PacktPublishing/Architecting-High-Performance-Embedded-Systems/README.md

# Architecting High-Performance Embedded Systems

<a href="https://www.packtpub.com/product/architecting-high-performance-embedded-systems/9781789955965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">Architecting High-Performance Embedded Systems</a>

This is the code repository for [Architecting High-Performance Embedded Systems](https://www.packtpub.com/product/architecting-high-performance-embedded-systems/9781789955965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), published by Packt.

**Design and build high-performance real-time digital systems based on FPGAs and custom circuits**

## What is this book about?
Modern digital devices used in homes, cars, and wearables contain highly sophisticated computing capabilities composed of embedded systems that generate, receive, and process digital data streams at rates up to multiple gigabits per second. This book will show you how to use Field Programmable Gate Arrays (FPGAs) and high-speed digital circuit design to create your own cutting-edge digital systems. 

This book covers the following exciting features:
* Understand the fundamentals of real-time embedded systems and sensors
* Discover the capabilities of FPGAs and how to use FPGA development tools
* Learn the principles of digital circuit design and PCB layout with KiCad
* Construct high-speed circuit board prototypes at low cost
* Design and develop high-performance algorithms for FPGAs
Develop robust, reliable, and efficient firmware in C
Thoroughly test and debug embedded device hardware and firmware

If you feel this book is for you, get your [copy](https://www.amazon.com/dp/1789955963) today!

## Instructions and Navigation
All of the code is organized into folders based on chapter number.

**What you need to work with the examples in this book:**
This book is for software developers, IoT engineers, and anyone who wants to understand the process of developing high-performance embedded systems. You’ll also find this book useful if you want to learn about the fundamentals of FPGA development and all aspects of firmware development in C and C++. Familiarity with the C language, digital circuits, and electronic soldering is necessary to get started.

With the following software and hardware you can run all code files present in the book.
### Software and Hardware List
| Software or hardware | OS required |
| --- | --- |
| [Xilinx Vivado](https://www.xilinx.com/support/download.html) | Windows, Mac OS X, and Linux (Any) |
| [KiCad](https://kicad.org/download/) | Windows, Mac OS X, and Linux (Any) |
| [Arty A7-100](https://www.xilinx.com/products/boards-and-kits/1-w51quh.html) | Windows, Mac OS X, and Linux (Any) |

We also provide a PDF file that has color images of the screenshots/diagrams used in this book. [Click here to download it](https://static.packt-cdn.com/downloads/9781789955965_ColorImages.pdf).

## Get to Know the Author
**Jim Ledin**
Jim Ledin is the CEO of Ledin Engineering, Inc. Jim is an expert in embedded software and hardware design, development, and testing. He is also accomplished in embedded system cybersecurity assessment and penetration testing. He has a B.S. degree in aerospace engineering from Iowa State University and an M.S. degree in electrical and computer engineering from Georgia Institute of Technology. Jim is a registered professional electrical engineer in California, a Certified Information System Security Professional (CISSP), a Certified Ethical Hacker (CEH), and a Certified Penetration Tester (CPT).

## Other books by the author
* Modern Computer Architecture and Organization [[Packt]](https://www.packtpub.com/in/cloud-networking/modern-computer-architecture-and-organization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) [[Amazon]](https://www.amazon.com/dp/1838984399)
### Download a free PDF

 <i>If you have already purchased a print or Kindle version of this book, you can get a DRM-free PDF version at no cost.<br>Simply click on the link to claim your free PDF.</i>
<p align="center"> <a href="https://packt.link/free-ebook/9781789955965">https://packt.link/free-ebook/9781789955965 </a> </p>
