PacktPublishing/Architecting-High-Performance-Embedded-Systems/Chapter02/README.md

__Architecting-High-Performance-Embedded-Systems__, by Jim Ledin. Published by Packt Publishing.
# Chapter 2 - Sensing the world

This chapter introduces the principles and implementations of sensors used in a wide variety of embedded applications. Passive sensors measure attributes of the world such as temperature, pressure, humidity, light intensity, and atmospheric composition. Active sensors use energy-emitting technologies like radar and lidar to detect objects and measure their position and velocity.

This chapter introduces a broad range of sensor types as well as the communication protocols used for transferring sensor data into a processor. The chapter also discusses the processing an embedded system must perform on raw sensor measurements to provide actionable data for use by a processing algorithm. 

After completing this chapter, you will have learned about many of the different types of sensors used in embedded systems and will understand what passive and active sensors are and will be familiar with several types of passive and active sensors. You will also understand some of the data processing methods commonly used on the raw measurements provided by sensors.

We will cover the following topics in this chapter: 
* Introducing passive, active and smart sensors
* Applying analog-to-digital converters and sensor circuits
* The types of sensors used in embedded systems
* Communicating with sensors
* Processing sensor data

# Chapter Files

[ArduinoHysteresis.c.ino](src/ArduinoHysteresis.c.ino) is the Arduino implementation of the phototransistor sensor processing algorithm presented in the *Communicating with sensors* section of chapter 2.
