PacktPublishing/Architecting-High-Performance-Embedded-Systems/Chapter04/README.md

__Architecting-High-Performance-Embedded-Systems__, by Jim Ledin. Published by Packt Publishing.
# Chapter 4 - Developing your first FPGA program

This chapter begins with a discussion on the effective use of FPGA devices in real-time embedded systems and continues with a description of the functional elements contained within standard FPGAs. The range of FPGA design languages, including hardware description languages (HDLs), block diagram methods, and popular software programming languages including C and C++, is introduced. The chapter continues with an overview of the FPGA development process and concludes with a complete example of an FPGA development cycle starting with a statement of system requirements and ending with a functional system implemented in a low-cost FPGA development board.

After completing this chapter, you will know how FPGAs can be applied in real-time embedded system architectures and will understand the components that make up an FPGA integrated circuit. You will have learned about the programming languages used in the design of FPGA algorithms and will understand the sequence of steps to develop an FPGA-based application. You will also have worked through a complete FPGA development example on a low-cost development board using free FPGA software tools.

We will cover the following topics in this chapter: 
* Using FPGAs in real-time embedded system designs
* FPGA implementation languages
* The FPGA development process
* Developing your first FPGA project

# Chapter Files

[ArtyAdder project](src/ArtyAdder) contains the final version of the Vivado project example we worked through in Chapter 4.
