PacktPublishing/Architecting-High-Performance-Embedded-Systems/Chapter06/src/oscilloscope-circuit/Oscilloscope.kicad_pcb

## KiCad design Chapter06/src/oscilloscope-circuit/Oscilloscope.kicad_pcb (2021-01-16)

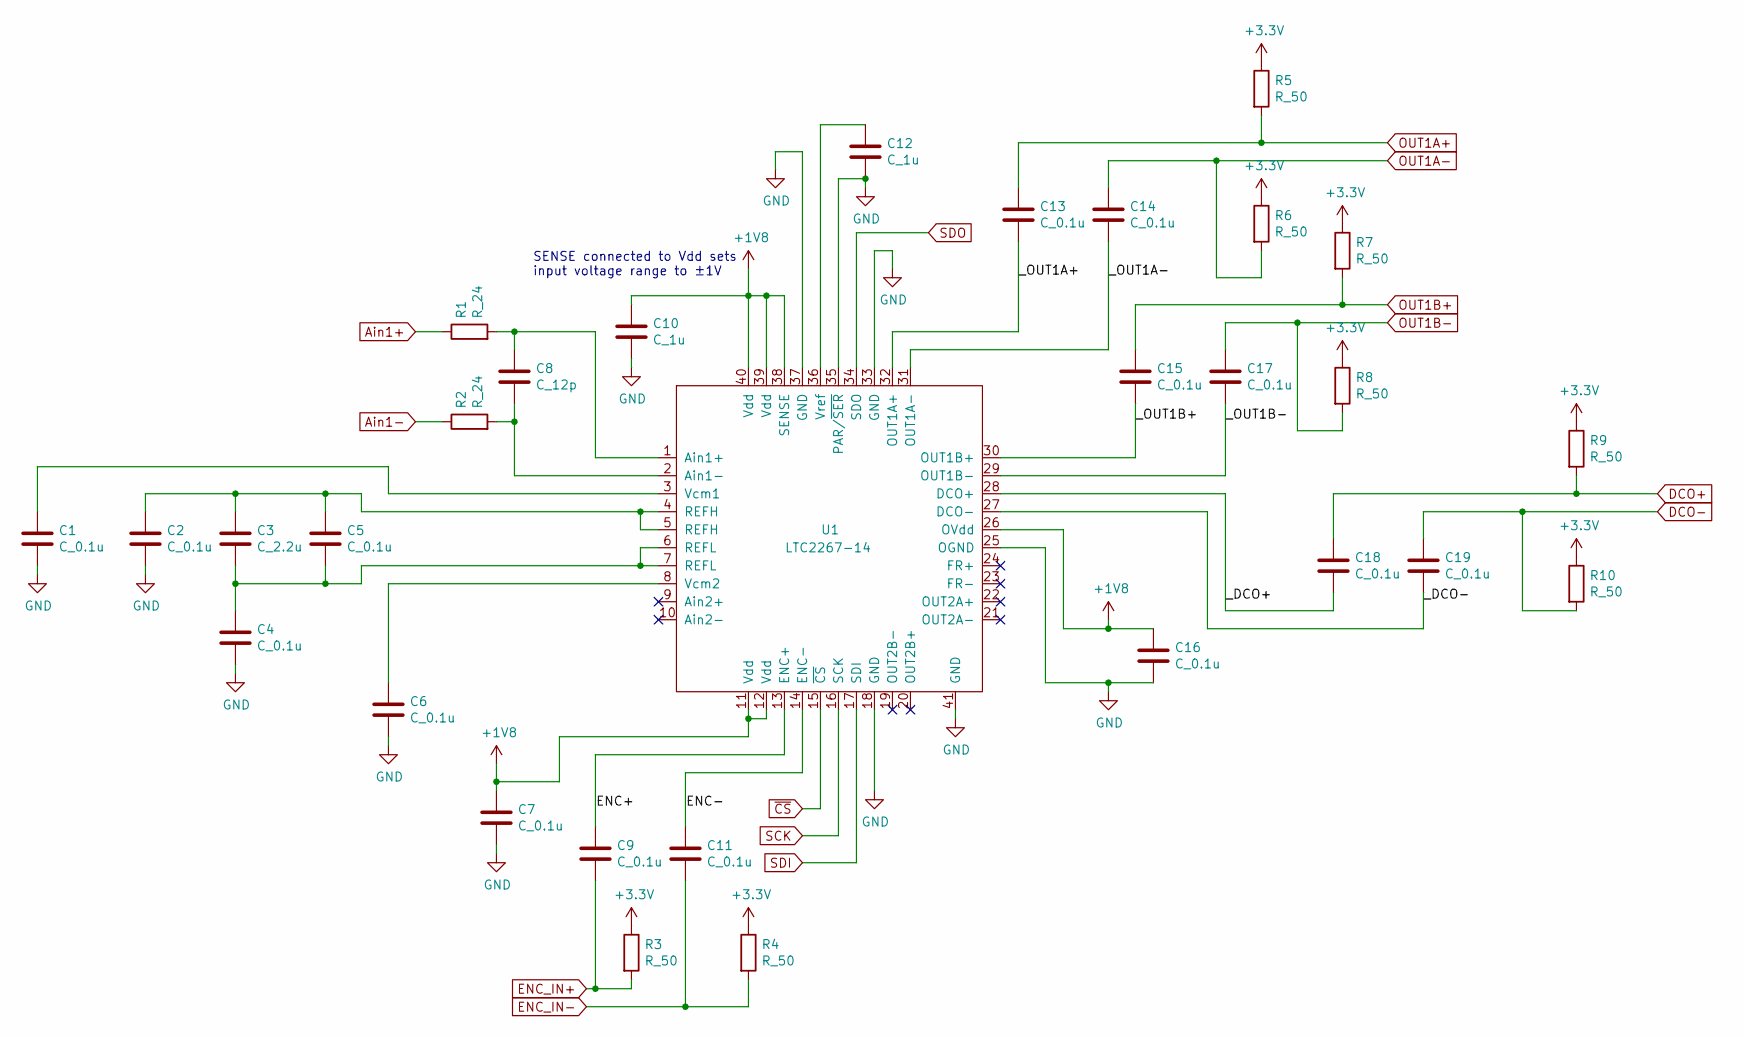
[picture p1: schematic ADC.sch]

Parts:
C1, C2, C4, C5, C6, C7, C9, C11, C13, C14, C15, C16, C17, C18, C19: C_0.1u; C_0402_1005Metric
C3: C_2.2u; C_0603_1608Metric
C8: C_12p; C_0402_1005Metric
C10, C12: C_1u; C_0603_1608Metric
R1, R2: R_24; R_0402_1005Metric
R3, R4, R5, R6, R7, R8, R9, R10: R_50; R_0402_1005Metric
U1: LTC2267-14; QFN-40-1EP_6x6mm_P0.5mm_EP4.6x4.6mm_ThermalVias

Connections:
+1V8: C7.1, C10.1, C16.1, U1.11 (Vdd), U1.12 (Vdd), U1.26 (OVdd), U1.38 (SENSE), U1.39 (Vdd), U1.40 (Vdd); also elsewhere on the board
+3V3: R3.1, R4.1, R5.1, R6.1, R7.1, R8.1, R9.1, R10.1; also elsewhere on the board
/ADC/ENC+: C9.1, U1.13 (ENC+)
/ADC/ENC-: C11.1, U1.14 (ENC-)
/ADC/_DCO+: C18.2, U1.28 (DCO+)
/ADC/_DCO-: C19.2, U1.27 (DCO-)
/ADC/_OUT1A+: C13.2, U1.32 (OUT1A+)
/ADC/_OUT1A-: C14.2, U1.31 (OUT1A-)
/ADC/_OUT1B+: C15.2, U1.30 (OUT1B+)
/ADC/_OUT1B-: C17.2, U1.29 (OUT1B-)
Ain1+: R1.1; also elsewhere on the board
Ain1-: R2.1; also elsewhere on the board
DCO+: C18.1, R9.2; also elsewhere on the board
DCO-: C19.1, R10.2; also elsewhere on the board
ENC_IN+: C9.2, R3.2; also elsewhere on the board
ENC_IN-: C11.2, R4.2; also elsewhere on the board
GND: C1.2, C2.2, C4.2, C6.2, C7.2, C10.2, C12.2, C16.2, U1.18 (GND), U1.25 (OGND), U1.33 (GND), U1.35 (PAR/~SER), U1.37 (GND), U1.41 (GND); also elsewhere on the board
unnamed: C1.1, U1.3 (Vcm1)
unnamed: C2.1, C3.1, C5.1, U1.4 (REFH), U1.5 (REFH)
unnamed: C3.2, C4.1, C5.2, U1.6 (REFL), U1.7 (REFL)
unnamed: C6.1, U1.8 (Vcm2)
unnamed: C8.1, R1.2, U1.1 (Ain1+)
unnamed: C8.2, R2.2, U1.2 (Ain1-)
unnamed: C12.1, U1.36 (Vref)
OUT1A+: C13.1, R5.2; also elsewhere on the board
OUT1A-: C14.1, R6.2; also elsewhere on the board
OUT1B+: C15.1, R7.2; also elsewhere on the board
OUT1B-: C17.1, R8.2; also elsewhere on the board
SCK: U1.16 (SCK); also elsewhere on the board
SDI: U1.17 (SDI); also elsewhere on the board
SDO: U1.34 (SDO); also elsewhere on the board
~CS: U1.15 (~CS); also elsewhere on the board

Notes on the sheet:
SENSE connected to Vdd sets input voltage range to ±1V

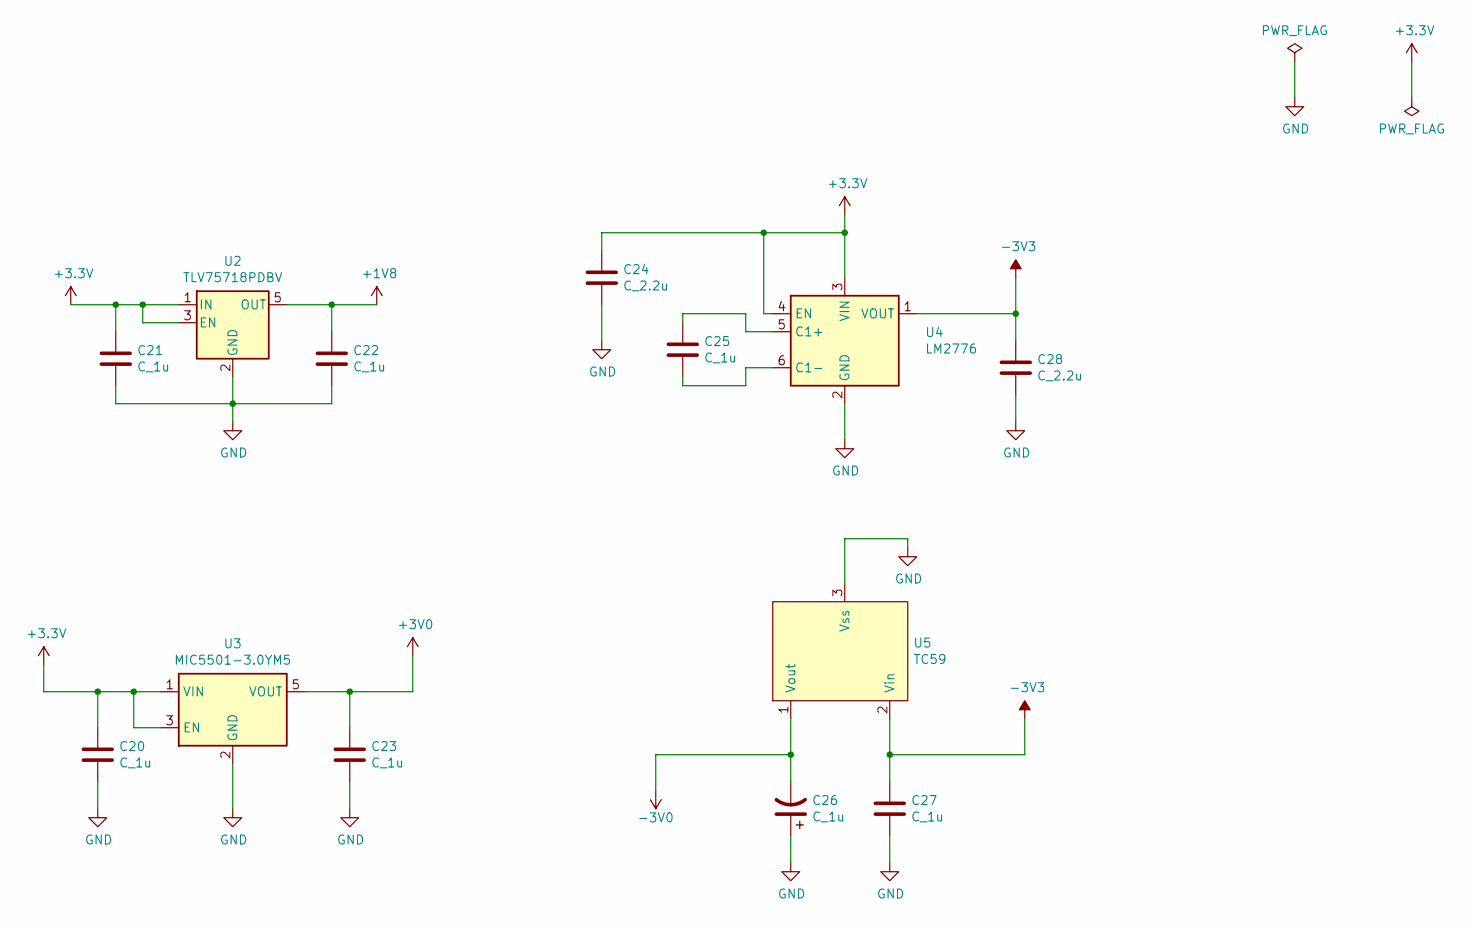
[picture p2: schematic Power Supply.sch]

Parts:
C20, C21, C22, C23, C25, C27: C_1u; C_0603_1608Metric
C24, C28: C_2.2u; C_0603_1608Metric
C26: C_1u; CP_EIA-2012-12_Kemet-R
U2: TLV75718PDBV; SOT-23-5
U3: MIC5501-3.0YM5; SOT-23-5
U4: LM2776; SOT-23-6
U5: TC59; SOT-23

Connections:
+1V8: C22.1, U2.5 (OUT); also elsewhere on the board
+3V0: C23.1, U3.5 (VOUT); also elsewhere on the board
+3V3: C20.1, C21.1, C24.1, U2.1 (IN), U2.3 (EN), U3.1 (VIN), U3.3 (EN), U4.3 (VIN), U4.4 (EN); also elsewhere on the board
-3V0: C26.2, U5.1 (Vout); also elsewhere on the board
-3V3: C27.1, C28.1, U4.1 (VOUT), U5.2 (Vin)
GND: C20.2, C21.2, C22.2, C23.2, C24.2, C26.1, C27.2, C28.2, U2.2 (GND), U3.2 (GND), U4.2 (GND), U5.3 (Vss); also elsewhere on the board
unnamed: C25.1, U4.5 (C1+)
unnamed: C25.2, U4.6 (C1-)

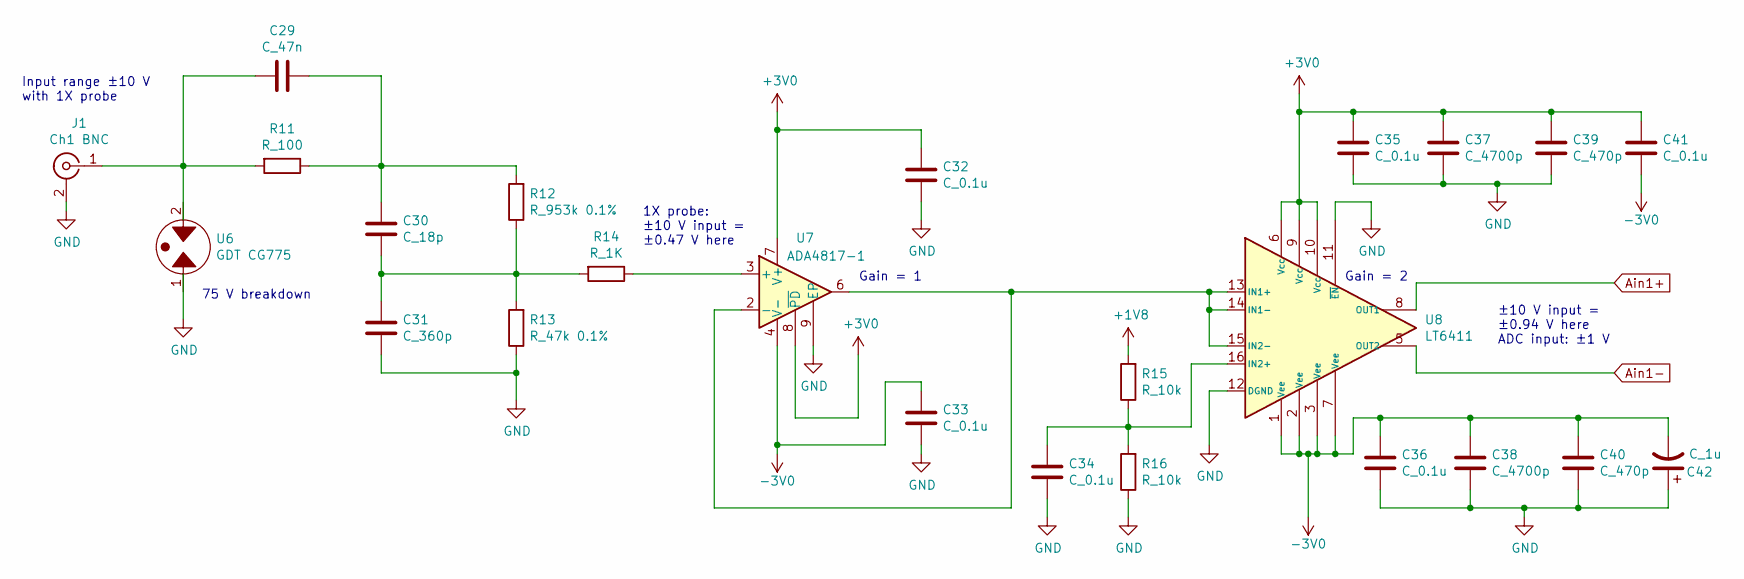
[picture p3: schematic Analog Inputs.sch]

Parts:
C29: C_47n; C_0402_1005Metric
C30: C_18p; C_0402_1005Metric
C31: C_360p; C_0402_1005Metric
C32, C33, C34, C35, C36, C41: C_0.1u; C_0402_1005Metric
C37, C38: C_4700p; C_0402_1005Metric
C39, C40: C_470p; C_0402_1005Metric
C42: C_1u; CP_EIA-2012-12_Kemet-R
J1: Ch1 BNC; BNC_Amphenol_B6252HB-NPP3G-50_Horizontal
R11: R_100; R_0402_1005Metric
R12: R_953k 0.1%; R_0402_1005Metric
R13: R_47k 0.1%; R_0402_1005Metric
R14: R_1K; R_0402_1005Metric
R15, R16: R_10k; R_0402_1005Metric
U6: GDT CG775; Littelfuse-GTCC23-XXXM-R01-2-Series-GDT
U7: ADA4817-1; SOIC-8-1EP_3.9x4.9mm_P1.27mm_EP2.29x3mm
U8: LT6411; QFN-16-1EP_3x3mm_P0.5mm_EP1.7x1.7mm

Connections:
+1V8: R15.2; also elsewhere on the board
+3V0: C32.2, C35.2, C37.2, C39.2, C41.2, U7.7 (V+), U7.8 (~PD), U8.6 (Vcc), U8.9 (Vcc), U8.10 (Vcc); also elsewhere on the board
-3V0: C33.2, C36.2, C38.2, C40.2, C41.1, C42.2, U7.4 (V-), U8.1 (Vee), U8.2 (Vee), U8.3 (Vee), U8.7 (Vee); also elsewhere on the board
Ain1+: U8.8 (OUT1); also elsewhere on the board
Ain1-: U8.5 (OUT2); also elsewhere on the board
GND: C31.1, C32.1, C33.1, C34.1, C35.1, C36.1, C37.1, C38.1, C39.1, C40.1, C42.1, J1.2 (Ext), R13.1, R16.1, U6.1, U7.9 (EP), U8.11 (~EN), U8.12 (DGND); also elsewhere on the board
unnamed: C29.1, C30.2, R11.1, R12.2
unnamed: C29.2, J1.1 (In), R11.2, U6.2
unnamed: C30.1, C31.2, R12.1, R13.2, R14.2
unnamed: C34.2, R15.1, R16.2, U8.16 (IN2+)
unnamed: R14.1, U7.3 (+)
unnamed: U7.2 (-), U7.6, U8.13 (IN1+), U8.14 (IN1-), U8.15 (IN2-)

Notes on the sheet:
Input range ±10 V with 1X probe
Gain = 2
1X probe: ±10 V input = ±0.47 V here
±10 V input = ±0.94 V here ADC input: ±1 V
Gain = 1
75 V breakdown

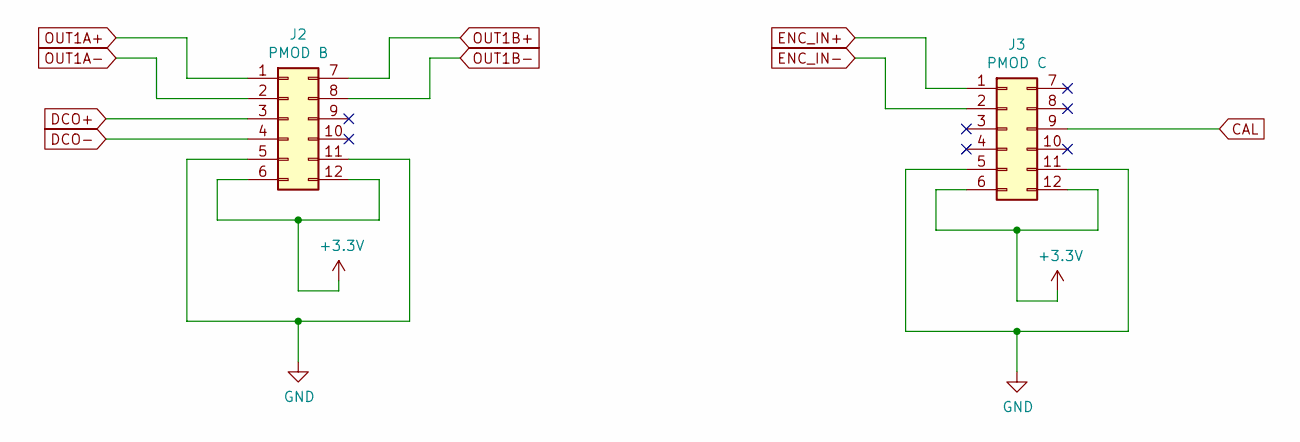
[picture p4: schematic PMOD Ports.sch]

Parts:
J2: PMOD B; PinHeader_2x06_P2.54mm_renumbered
J3: PMOD C; PinHeader_2x06_P2.54mm_renumbered

Connections:
+3V3: J2.6, J2.12, J3.6, J3.12; also elsewhere on the board
CAL: J3.9; also elsewhere on the board
DCO+: J2.3; also elsewhere on the board
DCO-: J2.4; also elsewhere on the board
ENC_IN+: J3.1; also elsewhere on the board
ENC_IN-: J3.2; also elsewhere on the board
GND: J2.5, J2.11, J3.5, J3.11; also elsewhere on the board
OUT1A+: J2.1; also elsewhere on the board
OUT1A-: J2.2; also elsewhere on the board
OUT1B+: J2.7; also elsewhere on the board
OUT1B-: J2.8; also elsewhere on the board

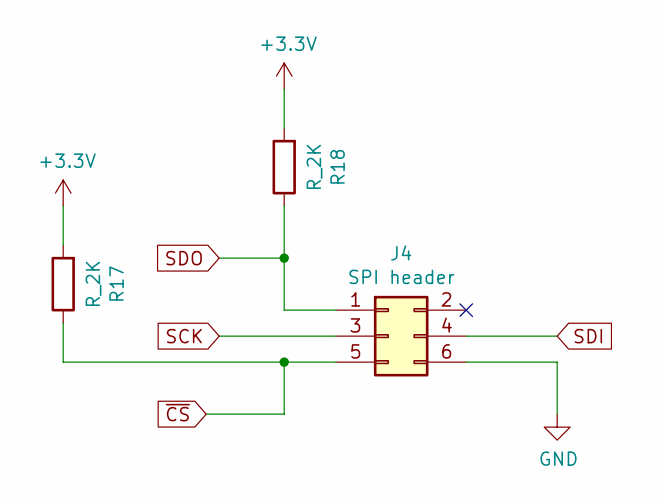
[picture p5: schematic SPI.sch]

Parts:
J4: SPI header; PinHeader_2x03_P2.54mm_Vertical
R17, R18: R_2K; R_0402_1005Metric

Connections:
+3V3: R17.2, R18.2; also elsewhere on the board
GND: J4.6; also elsewhere on the board
SCK: J4.3; also elsewhere on the board
SDI: J4.4; also elsewhere on the board
SDO: J4.1, R18.1; also elsewhere on the board
~CS: J4.5, R17.1; also elsewhere on the board

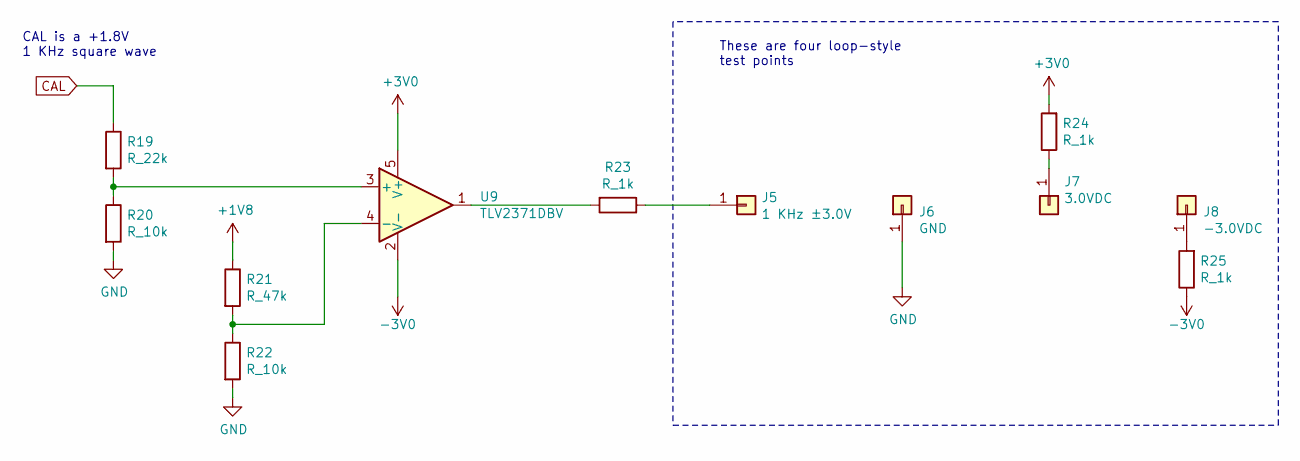
[picture p6: schematic Calibration.sch]

Parts:
J5: 1 KHz ±3.0V; TestPoint_Loop_D2.60mm_Drill1.6mm_Beaded
J6: GND; TestPoint_Loop_D2.60mm_Drill1.6mm_Beaded
J7: 3.0VDC; TestPoint_Loop_D2.60mm_Drill1.6mm_Beaded
J8: -3.0VDC; TestPoint_Loop_D2.60mm_Drill1.6mm_Beaded
R19: R_22k; R_0402_1005Metric
R20, R22: R_10k; R_0402_1005Metric
R21: R_47k; R_0402_1005Metric
R23, R24, R25: R_1k; R_0402_1005Metric
U9: TLV2371DBV; SOT-23-5

Connections:
+1V8: R21.1; also elsewhere on the board
+3V0: R24.2, U9.5 (V+); also elsewhere on the board
-3V0: R25.1, U9.2 (V-); also elsewhere on the board
CAL: R19.1; also elsewhere on the board
GND: J6.1, R20.2, R22.2; also elsewhere on the board
unnamed: J5.1, R23.1
unnamed: J7.1, R24.1
unnamed: J8.1, R25.2
unnamed: R19.2, R20.1, U9.3 (+)
unnamed: R21.2, R22.1, U9.4 (-)
unnamed: R23.2, U9.1

Notes on the sheet:
CAL is a +1.8V 1 KHz square wave
These are four loop-style test points

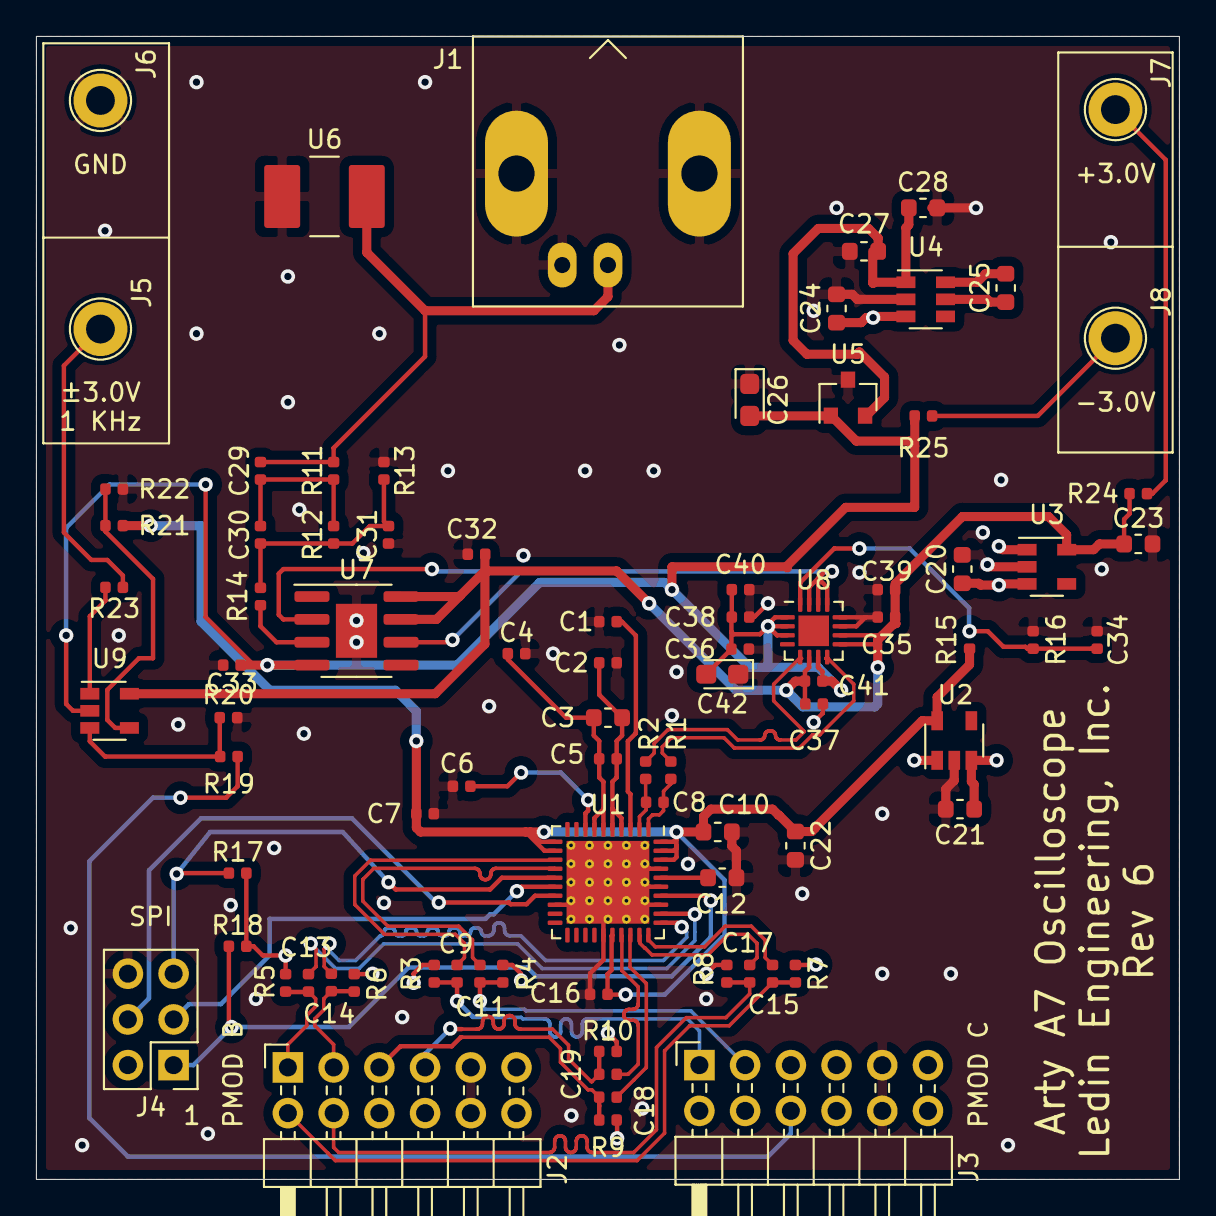
[picture p7: board Oscilloscope.kicad_pcb from above]

Board: 4 copper layers, 63.5 x 63.5 mm, 84 parts (0 on the bottom side), 50 nets.
