PacktPublishing/Architecting-High-Performance-Embedded-Systems/Chapter04/src/ArtyAdder/ArtyAdder.runs/synth_1/.Xil/ARTY_ADDER_propImpl.xdc

set_property SRC_FILE_INFO {cfile:C:/Projects/Architecting-High-Performance-Embedded-Systems/Chapter04/src/ArtyAdder/ArtyAdder.srcs/constrs_1/new/Arty-A7-100.xdc rfile:../../../ArtyAdder.srcs/constrs_1/new/Arty-A7-100.xdc id:1} [current_design]
set_property src_info {type:XDC file:1 line:11 export:INPUT save:INPUT read:READ} [current_design]
set_property -dict { PACKAGE_PIN A8    IOSTANDARD LVCMOS33 } [get_ports { sw[0] }]; #IO_L12N_T1_MRCC_16 Sch=sw[0]
set_property src_info {type:XDC file:1 line:12 export:INPUT save:INPUT read:READ} [current_design]
set_property -dict { PACKAGE_PIN C11   IOSTANDARD LVCMOS33 } [get_ports { sw[1] }]; #IO_L13P_T2_MRCC_16 Sch=sw[1]
set_property src_info {type:XDC file:1 line:13 export:INPUT save:INPUT read:READ} [current_design]
set_property -dict { PACKAGE_PIN C10   IOSTANDARD LVCMOS33 } [get_ports { sw[2] }]; #IO_L13N_T2_MRCC_16 Sch=sw[2]
set_property src_info {type:XDC file:1 line:14 export:INPUT save:INPUT read:READ} [current_design]
set_property -dict { PACKAGE_PIN A10   IOSTANDARD LVCMOS33 } [get_ports { sw[3] }]; #IO_L14P_T2_SRCC_16 Sch=sw[3]
set_property src_info {type:XDC file:1 line:18 export:INPUT save:INPUT read:READ} [current_design]
set_property -dict { PACKAGE_PIN F6    IOSTANDARD LVCMOS33 } [get_ports { led0_g }]; #IO_L19N_T3_VREF_35 Sch=led0_g
set_property src_info {type:XDC file:1 line:31 export:INPUT save:INPUT read:READ} [current_design]
set_property -dict { PACKAGE_PIN H5    IOSTANDARD LVCMOS33 } [get_ports { led[0] }]; #IO_L24N_T3_35 Sch=led[4]
set_property src_info {type:XDC file:1 line:32 export:INPUT save:INPUT read:READ} [current_design]
set_property -dict { PACKAGE_PIN J5    IOSTANDARD LVCMOS33 } [get_ports { led[1] }]; #IO_25_35 Sch=led[5]
set_property src_info {type:XDC file:1 line:33 export:INPUT save:INPUT read:READ} [current_design]
set_property -dict { PACKAGE_PIN T9    IOSTANDARD LVCMOS33 } [get_ports { led[2] }]; #IO_L24P_T3_A01_D17_14 Sch=led[6]
set_property src_info {type:XDC file:1 line:34 export:INPUT save:INPUT read:READ} [current_design]
set_property -dict { PACKAGE_PIN T10   IOSTANDARD LVCMOS33 } [get_ports { led[3] }]; #IO_L24N_T3_A00_D16_14 Sch=led[7]
set_property src_info {type:XDC file:1 line:37 export:INPUT save:INPUT read:READ} [current_design]
set_property -dict { PACKAGE_PIN D9    IOSTANDARD LVCMOS33 } [get_ports { btn[0] }]; #IO_L6N_T0_VREF_16 Sch=btn[0]
set_property src_info {type:XDC file:1 line:38 export:INPUT save:INPUT read:READ} [current_design]
set_property -dict { PACKAGE_PIN C9    IOSTANDARD LVCMOS33 } [get_ports { btn[1] }]; #IO_L11P_T1_SRCC_16 Sch=btn[1]
set_property src_info {type:XDC file:1 line:39 export:INPUT save:INPUT read:READ} [current_design]
set_property -dict { PACKAGE_PIN B9    IOSTANDARD LVCMOS33 } [get_ports { btn[2] }]; #IO_L11N_T1_SRCC_16 Sch=btn[2]
set_property src_info {type:XDC file:1 line:40 export:INPUT save:INPUT read:READ} [current_design]
set_property -dict { PACKAGE_PIN B8    IOSTANDARD LVCMOS33 } [get_ports { btn[3] }]; #IO_L12P_T1_MRCC_16 Sch=btn[3]
