PacktPublishing/Architecting-High-Performance-Embedded-Systems/Chapter05/src/Adder4LUT.vhd

-- Load the standard libraries

library IEEE;
  use IEEE.STD_LOGIC_1164.ALL;

-- Define the 4-bit adder inputs and outputs

entity ADDER4LUT is
  port (
    A4     : in    std_logic_vector(3 downto 0);
    B4     : in    std_logic_vector(3 downto 0);
    SUM4   : out   std_logic_vector(3 downto 0);
    C_OUT4 : out   std_logic
  );
end entity ADDER4LUT;

-- Define the behavior of the 4-bit adder

architecture BEHAVIORAL of ADDER4LUT is

begin

  ADDER_LUT : process (A4, B4) is

    variable concat_input : std_logic_vector(7 downto 0);

  begin

    concat_input := A4 & B4;

    case concat_input is

      when "00000000" =>
        SUM4 <= "0000"; C_OUT4 <= '0';
      when "00000001" =>
        SUM4 <= "0001"; C_OUT4 <= '0';
      when "00000010" =>
        SUM4 <= "0010"; C_OUT4 <= '0';
      when "00000011" =>
        SUM4 <= "0011"; C_OUT4 <= '0';
      when "00000100" =>
        SUM4 <= "0100"; C_OUT4 <= '0';
      when "00000101" =>
        SUM4 <= "0101"; C_OUT4 <= '0';
      when "00000110" =>
        SUM4 <= "0110"; C_OUT4 <= '0';
      when "00000111" =>
        SUM4 <= "0111"; C_OUT4 <= '0';
      when "00001000" =>
        SUM4 <= "1000"; C_OUT4 <= '0';
      when "00001001" =>
        SUM4 <= "1001"; C_OUT4 <= '0';
      when "00001010" =>
        SUM4 <= "1010"; C_OUT4 <= '0';
      when "00001011" =>
        SUM4 <= "1011"; C_OUT4 <= '0';
      when "00001100" =>
        SUM4 <= "1100"; C_OUT4 <= '0';
      when "00001101" =>
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
        SUM4 <= "1100"; C_OUT4 <= '1';
      when "11111110" =>
        SUM4 <= "1101"; C_OUT4 <= '1';
      when "11111111" =>
        SUM4 <= "1110"; C_OUT4 <= '1';
      when others =>
        SUM4 <= "UUUU"; C_OUT4 <= 'U';

    end case;

  end process ADDER_LUT;

end architecture BEHAVIORAL;
