PacktPublishing/Architecting-High-Performance-Embedded-Systems/Chapter08/src/oscilloscope-fpga/oscilloscope-fpga.srcs/sources_1/bd/design_1/ip/design_1_mig_7series_0_0/design_1_mig_7series_0_0/example_design/sim/sim_tb_top.v

//*****************************************************************************

// (c) Copyright 2009 - 2010 Xilinx, Inc. All rights reserved.

//

// This file contains confidential and proprietary information

// of Xilinx, Inc. and is protected under U.S. and

// international copyright and other intellectual property

// laws.

//

// DISCLAIMER

// This disclaimer is not a license and does not grant any

// rights to the materials distributed herewith. Except as

// otherwise provided in a valid license issued to you by

// Xilinx, and to the maximum extent permitted by applicable

// law: (1) THESE MATERIALS ARE MADE AVAILABLE "AS IS" AND

// WITH ALL FAULTS, AND XILINX HEREBY DISCLAIMS ALL WARRANTIES

// AND CONDITIONS, EXPRESS, IMPLIED, OR STATUTORY, INCLUDING

// BUT NOT LIMITED TO WARRANTIES OF MERCHANTABILITY, NON-

// INFRINGEMENT, OR FITNESS FOR ANY PARTICULAR PURPOSE; and

// (2) Xilinx shall not be liable (whether in contract or tort,

// including negligence, or under any other theory of

// liability) for any loss or damage of any kind or nature

// related to, arising under or in connection with these

// materials, including for any direct, or any indirect,

// special, incidental, or consequential loss or damage

// (including loss of data, profits, goodwill, or any type of

// loss or damage suffered as a result of any action brought

// by a third party) even if such damage or loss was

// reasonably foreseeable or Xilinx had been advised of the

// possibility of the same.

//

// CRITICAL APPLICATIONS

// Xilinx products are not designed or intended to be fail-

// safe, or for use in any application requiring fail-safe

// performance, such as life-support or safety devices or

// systems, Class III medical devices, nuclear facilities,

// applications related to the deployment of airbags, or any

// other applications that could lead to death, personal

// injury, or severe property or environmental damage

// (individually and collectively, "Critical

// Applications"). Customer assumes the sole risk and

// liability of any use of Xilinx products in Critical

// Applications, subject only to applicable laws and

// regulations governing limitations on product liability.

//

// THIS COPYRIGHT NOTICE AND DISCLAIMER MUST BE RETAINED AS

// PART OF THIS FILE AT ALL TIMES.

//

//*****************************************************************************

//   ____  ____

//  /   /\/   /

// /___/  \  /    Vendor             : Xilinx

// \   \   \/     Version            : 4.2

//  \   \         Application        : MIG

//  /   /         Filename           : sim_tb_top.v

// /___/   /\     Date Last Modified : $Date: 2011/06/07 13:45:16 $

// \   \  /  \    Date Created       : Tue Sept 21 2010

//  \___\/\___\

//

// Device           : 7 Series

// Design Name      : DDR3 SDRAM

// Purpose          :

//                   Top-level testbench for testing DDR3.

//                   Instantiates:

//                     1. IP_TOP (top-level representing FPGA, contains core,

//                        clocking, built-in testbench/memory checker and other

//                        support structures)

//                     2. DDR3 Memory

//                     3. Miscellaneous clock generation and reset logic

//                     4. For ECC ON case inserts error on LSB bit

//                        of data from DRAM to FPGA.

// Reference        :

// Revision History :

//*****************************************************************************



`timescale 1ps/100fs



module sim_tb_top;





   //***************************************************************************

   // Traffic Gen related parameters

   //***************************************************************************

   parameter SIMULATION            = "TRUE";

   parameter BEGIN_ADDRESS         = 32'h00000000;

   parameter END_ADDRESS           = 32'h00000fff;

   parameter PRBS_EADDR_MASK_POS   = 32'hff000000;



   //***************************************************************************

   // The following parameters refer to width of various ports

   //***************************************************************************

   parameter COL_WIDTH             = 10;

                                     // # of memory Column Address bits.

   parameter CS_WIDTH              = 1;

                                     // # of unique CS outputs to memory.

   parameter DM_WIDTH              = 2;

                                     // # of DM (data mask)

   parameter DQ_WIDTH              = 16;

                                     // # of DQ (data)

   parameter DQS_WIDTH             = 2;

   parameter DQS_CNT_WIDTH         = 1;

                                     // = ceil(log2(DQS_WIDTH))

   parameter DRAM_WIDTH            = 8;

                                     // # of DQ per DQS

   parameter ECC                   = "OFF";

   parameter RANKS                 = 1;

                                     // # of Ranks.

   parameter ODT_WIDTH             = 1;

                                     // # of ODT outputs to memory.

   parameter ROW_WIDTH             = 14;

                                     // # of memory Row Address bits.

   parameter ADDR_WIDTH            = 28;

                                     // # = RANK_WIDTH + BANK_WIDTH

                                     //     + ROW_WIDTH + COL_WIDTH;

                                     // Chip Select is always tied to low for

                                     // single rank devices

   //***************************************************************************

   // The following parameters are mode register settings

   //***************************************************************************

   parameter BURST_MODE            = "8";

                                     // DDR3 SDRAM:

                                     // Burst Length (Mode Register 0).

                                     // # = "8", "4", "OTF".

                                     // DDR2 SDRAM:

                                     // Burst Length (Mode Register).

                                     // # = "8", "4".

   parameter CA_MIRROR             = "OFF";

                                     // C/A mirror opt for DDR3 dual rank

   

   //***************************************************************************

   // The following parameters are multiplier and divisor factors for PLLE2.

   // Based on the selected design frequency these parameters vary.

   //***************************************************************************

   parameter CLKIN_PERIOD          = 6000;

                                     // Input Clock Period





   //***************************************************************************

   // Simulation parameters

   //***************************************************************************

   parameter SIM_BYPASS_INIT_CAL   = "FAST";

                                     // # = "SIM_INIT_CAL_FULL" -  Complete

                                     //              memory init &

                                     //              calibration sequence

                                     // # = "SKIP" - Not supported

                                     // # = "FAST" - Complete memory init & use

                                     //              abbreviated calib sequence



   //***************************************************************************

   // IODELAY and PHY related parameters

   //***************************************************************************

   parameter TCQ                   = 100;

   //***************************************************************************

   // IODELAY and PHY related parameters

   //***************************************************************************

   parameter RST_ACT_LOW           = 1;

                                     // =1 for active low reset,

                                     // =0 for active high.



   //***************************************************************************

   // Referece clock frequency parameters

   //***************************************************************************

   parameter REFCLK_FREQ           = 200.0;

                                     // IODELAYCTRL reference clock frequency

   //***************************************************************************

   // System clock frequency parameters

   //***************************************************************************

   parameter tCK                   = 3000;

                                     // memory tCK paramter.

                     // # = Clock Period in pS.

   parameter nCK_PER_CLK           = 4;

                                     // # of memory CKs per fabric CLK



   

   //***************************************************************************

   // AXI4 Shim parameters

   //***************************************************************************

   parameter C_S_AXI_ID_WIDTH              = 2;

                                             // Width of all master and slave ID signals.

                                             // # = >= 1.

   parameter C_S_AXI_ADDR_WIDTH            = 28;

                                             // Width of S_AXI_AWADDR, S_AXI_ARADDR, M_AXI_AWADDR and

                                             // M_AXI_ARADDR for all SI/MI slots.

                                             // # = 32.

   parameter C_S_AXI_DATA_WIDTH            = 128;

                                             // Width of WDATA and RDATA on SI slot.

                                             // Must be <= APP_DATA_WIDTH.

                                             // # = 32, 64, 128, 256.

   parameter C_S_AXI_SUPPORTS_NARROW_BURST = 0;

                                             // Indicates whether to instatiate upsizer

                                             // Range: 0, 1





   //***************************************************************************

   // Debug and Internal parameters

   //***************************************************************************

   parameter DEBUG_PORT            = "OFF";

                                     // # = "ON" Enable debug signals/controls.

                                     //   = "OFF" Disable debug signals/controls.

   //***************************************************************************

   // Debug and Internal parameters

   //***************************************************************************

   parameter DRAM_TYPE             = "DDR3";



    



  //**************************************************************************//

  // Local parameters Declarations

  //**************************************************************************//



  localparam real TPROP_DQS          = 0.00;

                                       // Delay for DQS signal during Write Operation

  localparam real TPROP_DQS_RD       = 0.00;

                       // Delay for DQS signal during Read Operation

  localparam real TPROP_PCB_CTRL     = 0.00;

                       // Delay for Address and Ctrl signals

  localparam real TPROP_PCB_DATA     = 0.00;

                       // Delay for data signal during Write operation

  localparam real TPROP_PCB_DATA_RD  = 0.00;

                       // Delay for data signal during Read operation



  localparam MEMORY_WIDTH            = 16;

  localparam NUM_COMP                = DQ_WIDTH/MEMORY_WIDTH;

  localparam ECC_TEST 		   	= "OFF" ;

  localparam ERR_INSERT = (ECC_TEST == "ON") ? "OFF" : ECC ;

  



  localparam real REFCLK_PERIOD = (1000000.0/(2*REFCLK_FREQ));

  localparam RESET_PERIOD = 200000; //in pSec  

  localparam real SYSCLK_PERIOD = tCK;

    

    



  //**************************************************************************//

  // Wire Declarations

  //**************************************************************************//

  reg                                sys_rst_n;

  wire                               sys_rst;





  reg                     sys_clk_i;



  reg clk_ref_i;



  

  wire                               ddr3_reset_n;

  wire [DQ_WIDTH-1:0]                ddr3_dq_fpga;

  wire [DQS_WIDTH-1:0]               ddr3_dqs_p_fpga;

  wire [DQS_WIDTH-1:0]               ddr3_dqs_n_fpga;

  wire [ROW_WIDTH-1:0]               ddr3_addr_fpga;

  wire [3-1:0]              ddr3_ba_fpga;

  wire                               ddr3_ras_n_fpga;

  wire                               ddr3_cas_n_fpga;

  wire                               ddr3_we_n_fpga;

  wire [1-1:0]               ddr3_cke_fpga;

  wire [1-1:0]                ddr3_ck_p_fpga;

  wire [1-1:0]                ddr3_ck_n_fpga;

    

  

  wire                               init_calib_complete;

  wire                               tg_compare_error;

  wire [(CS_WIDTH*1)-1:0] ddr3_cs_n_fpga;

    

  wire [DM_WIDTH-1:0]                ddr3_dm_fpga;

    

  wire [ODT_WIDTH-1:0]               ddr3_odt_fpga;

    

  

  reg [(CS_WIDTH*1)-1:0] ddr3_cs_n_sdram_tmp;

    

  reg [DM_WIDTH-1:0]                 ddr3_dm_sdram_tmp;

    

  reg [ODT_WIDTH-1:0]                ddr3_odt_sdram_tmp;

    



  

  wire [DQ_WIDTH-1:0]                ddr3_dq_sdram;

  reg [ROW_WIDTH-1:0]                ddr3_addr_sdram [0:1];

  reg [3-1:0]               ddr3_ba_sdram [0:1];

  reg                                ddr3_ras_n_sdram;

  reg                                ddr3_cas_n_sdram;

  reg                                ddr3_we_n_sdram;

  wire [(CS_WIDTH*1)-1:0] ddr3_cs_n_sdram;

  wire [ODT_WIDTH-1:0]               ddr3_odt_sdram;

  reg [1-1:0]                ddr3_cke_sdram;

  wire [DM_WIDTH-1:0]                ddr3_dm_sdram;

  wire [DQS_WIDTH-1:0]               ddr3_dqs_p_sdram;

  wire [DQS_WIDTH-1:0]               ddr3_dqs_n_sdram;

  reg [1-1:0]                 ddr3_ck_p_sdram;

  reg [1-1:0]                 ddr3_ck_n_sdram;

  

    



//**************************************************************************//



  //**************************************************************************//

  // Reset Generation

  //**************************************************************************//

  initial begin

    sys_rst_n = 1'b0;

    #RESET_PERIOD

      sys_rst_n = 1'b1;

   end



   assign sys_rst = RST_ACT_LOW ? sys_rst_n : ~sys_rst_n;



  //**************************************************************************//

  // Clock Generation

  //**************************************************************************//



  initial

    sys_clk_i = 1'b0;

  always

    sys_clk_i = #(CLKIN_PERIOD/2.0) ~sys_clk_i;





  initial

    clk_ref_i = 1'b0;

  always

    clk_ref_i = #REFCLK_PERIOD ~clk_ref_i;









  always @( * ) begin

    ddr3_ck_p_sdram      <=  #(TPROP_PCB_CTRL) ddr3_ck_p_fpga;

    ddr3_ck_n_sdram      <=  #(TPROP_PCB_CTRL) ddr3_ck_n_fpga;

    ddr3_addr_sdram[0]   <=  #(TPROP_PCB_CTRL) ddr3_addr_fpga;

    ddr3_addr_sdram[1]   <=  #(TPROP_PCB_CTRL) (CA_MIRROR == "ON") ?

                                                 {ddr3_addr_fpga[ROW_WIDTH-1:9],

                                                  ddr3_addr_fpga[7], ddr3_addr_fpga[8],

                                                  ddr3_addr_fpga[5], ddr3_addr_fpga[6],

                                                  ddr3_addr_fpga[3], ddr3_addr_fpga[4],

                                                  ddr3_addr_fpga[2:0]} :

                                                 ddr3_addr_fpga;

    ddr3_ba_sdram[0]     <=  #(TPROP_PCB_CTRL) ddr3_ba_fpga;

    ddr3_ba_sdram[1]     <=  #(TPROP_PCB_CTRL) (CA_MIRROR == "ON") ?

                                                 {ddr3_ba_fpga[3-1:2],

                                                  ddr3_ba_fpga[0],

                                                  ddr3_ba_fpga[1]} :

                                                 ddr3_ba_fpga;

    ddr3_ras_n_sdram     <=  #(TPROP_PCB_CTRL) ddr3_ras_n_fpga;

    ddr3_cas_n_sdram     <=  #(TPROP_PCB_CTRL) ddr3_cas_n_fpga;

    ddr3_we_n_sdram      <=  #(TPROP_PCB_CTRL) ddr3_we_n_fpga;

    ddr3_cke_sdram       <=  #(TPROP_PCB_CTRL) ddr3_cke_fpga;

  end

    



  always @( * )

    ddr3_cs_n_sdram_tmp   <=  #(TPROP_PCB_CTRL) ddr3_cs_n_fpga;

  assign ddr3_cs_n_sdram =  ddr3_cs_n_sdram_tmp;

    



  always @( * )

    ddr3_dm_sdram_tmp <=  #(TPROP_PCB_DATA) ddr3_dm_fpga;//DM signal generation

  assign ddr3_dm_sdram = ddr3_dm_sdram_tmp;

    



  always @( * )

    ddr3_odt_sdram_tmp  <=  #(TPROP_PCB_CTRL) ddr3_odt_fpga;

  assign ddr3_odt_sdram =  ddr3_odt_sdram_tmp;

    



// Controlling the bi-directional BUS



  genvar dqwd;

  generate

    for (dqwd = 1;dqwd < DQ_WIDTH;dqwd = dqwd+1) begin : dq_delay

      WireDelay #

       (

        .Delay_g    (TPROP_PCB_DATA),

        .Delay_rd   (TPROP_PCB_DATA_RD),

        .ERR_INSERT ("OFF")

       )

      u_delay_dq

       (

        .A             (ddr3_dq_fpga[dqwd]),

        .B             (ddr3_dq_sdram[dqwd]),

        .reset         (sys_rst_n),

        .phy_init_done (init_calib_complete)

       );

    end

          WireDelay #

       (

        .Delay_g    (TPROP_PCB_DATA),

        .Delay_rd   (TPROP_PCB_DATA_RD),

        .ERR_INSERT ("OFF")

       )

      u_delay_dq_0

       (

        .A             (ddr3_dq_fpga[0]),

        .B             (ddr3_dq_sdram[0]),

        .reset         (sys_rst_n),

        .phy_init_done (init_calib_complete)

       );

  endgenerate



  genvar dqswd;

  generate

    for (dqswd = 0;dqswd < DQS_WIDTH;dqswd = dqswd+1) begin : dqs_delay

      WireDelay #

       (

        .Delay_g    (TPROP_DQS),

        .Delay_rd   (TPROP_DQS_RD),

        .ERR_INSERT ("OFF")

       )

      u_delay_dqs_p

       (

        .A             (ddr3_dqs_p_fpga[dqswd]),

        .B             (ddr3_dqs_p_sdram[dqswd]),

        .reset         (sys_rst_n),

        .phy_init_done (init_calib_complete)

       );



      WireDelay #

       (

        .Delay_g    (TPROP_DQS),

        .Delay_rd   (TPROP_DQS_RD),

        .ERR_INSERT ("OFF")

       )

      u_delay_dqs_n

       (

        .A             (ddr3_dqs_n_fpga[dqswd]),

        .B             (ddr3_dqs_n_sdram[dqswd]),

        .reset         (sys_rst_n),

        .phy_init_done (init_calib_complete)

       );

    end

  endgenerate

    



    



  //===========================================================================

  //                         FPGA Memory Controller

  //===========================================================================



  example_top #

    (



     .SIMULATION                (SIMULATION),

     .BEGIN_ADDRESS             (BEGIN_ADDRESS),

     .END_ADDRESS               (END_ADDRESS),

     .PRBS_EADDR_MASK_POS       (PRBS_EADDR_MASK_POS),



     .COL_WIDTH                 (COL_WIDTH),

     .CS_WIDTH                  (CS_WIDTH),

     .DM_WIDTH                  (DM_WIDTH),

    

     .DQ_WIDTH                  (DQ_WIDTH),

     .DQS_CNT_WIDTH             (DQS_CNT_WIDTH),

     .DRAM_WIDTH                (DRAM_WIDTH),

     .ECC_TEST                  (ECC_TEST),

     .RANKS                     (RANKS),

     .ROW_WIDTH                 (ROW_WIDTH),

     .ADDR_WIDTH                (ADDR_WIDTH),

     .BURST_MODE                (BURST_MODE),

     .TCQ                       (TCQ),



     

    .DRAM_TYPE                 (DRAM_TYPE),

    

     

    .nCK_PER_CLK               (nCK_PER_CLK),

    

     

     .C_S_AXI_ID_WIDTH          (C_S_AXI_ID_WIDTH),

     .C_S_AXI_ADDR_WIDTH        (C_S_AXI_ADDR_WIDTH),

     .C_S_AXI_DATA_WIDTH        (C_S_AXI_DATA_WIDTH),

     .C_S_AXI_SUPPORTS_NARROW_BURST (C_S_AXI_SUPPORTS_NARROW_BURST),

    

     .DEBUG_PORT                (DEBUG_PORT),

    

     .RST_ACT_LOW               (RST_ACT_LOW)

    )

   u_ip_top

     (



     .ddr3_dq              (ddr3_dq_fpga),

     .ddr3_dqs_n           (ddr3_dqs_n_fpga),

     .ddr3_dqs_p           (ddr3_dqs_p_fpga),



     .ddr3_addr            (ddr3_addr_fpga),

     .ddr3_ba              (ddr3_ba_fpga),

     .ddr3_ras_n           (ddr3_ras_n_fpga),

     .ddr3_cas_n           (ddr3_cas_n_fpga),

     .ddr3_we_n            (ddr3_we_n_fpga),

     .ddr3_reset_n         (ddr3_reset_n),

     .ddr3_ck_p            (ddr3_ck_p_fpga),

     .ddr3_ck_n            (ddr3_ck_n_fpga),

     .ddr3_cke             (ddr3_cke_fpga),

     .ddr3_cs_n            (ddr3_cs_n_fpga),

    

     .ddr3_dm              (ddr3_dm_fpga),

    

     .ddr3_odt             (ddr3_odt_fpga),

    

     

     .sys_clk_i            (sys_clk_i),

    

     .clk_ref_i            (clk_ref_i),

    

      .init_calib_complete (init_calib_complete),

      .tg_compare_error    (tg_compare_error),

      .sys_rst             (sys_rst)

     );



  //**************************************************************************//

  // Memory Models instantiations

  //**************************************************************************//



  genvar r,i;

  generate

    for (r = 0; r < CS_WIDTH; r = r + 1) begin: mem_rnk

      if(DQ_WIDTH/16) begin: mem

        for (i = 0; i < NUM_COMP; i = i + 1) begin: gen_mem

          ddr3_model u_comp_ddr3

            (

             .rst_n   (ddr3_reset_n),

             .ck      (ddr3_ck_p_sdram),

             .ck_n    (ddr3_ck_n_sdram),

             .cke     (ddr3_cke_sdram[r]),

             .cs_n    (ddr3_cs_n_sdram[r]),

             .ras_n   (ddr3_ras_n_sdram),

             .cas_n   (ddr3_cas_n_sdram),

             .we_n    (ddr3_we_n_sdram),

             .dm_tdqs (ddr3_dm_sdram[(2*(i+1)-1):(2*i)]),

             .ba      (ddr3_ba_sdram[r]),

             .addr    (ddr3_addr_sdram[r]),

             .dq      (ddr3_dq_sdram[16*(i+1)-1:16*(i)]),

             .dqs     (ddr3_dqs_p_sdram[(2*(i+1)-1):(2*i)]),

             .dqs_n   (ddr3_dqs_n_sdram[(2*(i+1)-1):(2*i)]),

             .tdqs_n  (),

             .odt     (ddr3_odt_sdram[r])

             );

        end

      end

      if (DQ_WIDTH%16) begin: gen_mem_extrabits

        ddr3_model u_comp_ddr3

          (

           .rst_n   (ddr3_reset_n),

           .ck      (ddr3_ck_p_sdram),

           .ck_n    (ddr3_ck_n_sdram),

           .cke     (ddr3_cke_sdram[r]),

           .cs_n    (ddr3_cs_n_sdram[r]),

           .ras_n   (ddr3_ras_n_sdram),

           .cas_n   (ddr3_cas_n_sdram),

           .we_n    (ddr3_we_n_sdram),

           .dm_tdqs ({ddr3_dm_sdram[DM_WIDTH-1],ddr3_dm_sdram[DM_WIDTH-1]}),

           .ba      (ddr3_ba_sdram[r]),

           .addr    (ddr3_addr_sdram[r]),

           .dq      ({ddr3_dq_sdram[DQ_WIDTH-1:(DQ_WIDTH-8)],

                      ddr3_dq_sdram[DQ_WIDTH-1:(DQ_WIDTH-8)]}),

           .dqs     ({ddr3_dqs_p_sdram[DQS_WIDTH-1],

                      ddr3_dqs_p_sdram[DQS_WIDTH-1]}),

           .dqs_n   ({ddr3_dqs_n_sdram[DQS_WIDTH-1],

                      ddr3_dqs_n_sdram[DQS_WIDTH-1]}),

           .tdqs_n  (),

           .odt     (ddr3_odt_sdram[r])

           );

      end

    end

  endgenerate

    

    





  //***************************************************************************

  // Reporting the test case status

  // Status reporting logic exists both in simulation test bench (sim_tb_top)

  // and sim.do file for ModelSim. Any update in simulation run time or time out

  // in this file need to be updated in sim.do file as well.

  //***************************************************************************

  initial

  begin : Logging

     fork

        begin : calibration_done

           wait (init_calib_complete);

           $display("Calibration Done");

           #50000000.0;

           if (!tg_compare_error) begin

              $display("TEST PASSED");

           end

           else begin

              $display("TEST FAILED: DATA ERROR");

           end

           disable calib_not_done;

            $finish;

        end



        begin : calib_not_done

           if (SIM_BYPASS_INIT_CAL == "SIM_INIT_CAL_FULL")

             #2500000000.0;

           else

             #1000000000.0;

           if (!init_calib_complete) begin

              $display("TEST FAILED: INITIALIZATION DID NOT COMPLETE");

           end

           disable calibration_done;

            $finish;

        end

     join

  end

    

endmodule
