PacktPublishing/Architecting-High-Performance-Embedded-Systems/(commit log)

2020-10-09 Working on chapter 6
    [ADC.sch, Analog Inputs.sch, Calibration.sch, Oscilloscope.kicad_pcb, Oscilloscope.sch, PMOD Ports.sch, Power Supply.sch, SPI.sch]
2021-01-16 Added chapters 9 and 10
    [Oscilloscope.csv, Oscilloscope.kicad_pcb, Oscilloscope.xlsx, Power Supply.sch]
